jwildey/ec535Project/(commit log)

2017-04-09 Update bluetoothClient.c
    Added the address of the robotic arm for bluetooth
2017-04-30 added folder for raspberry pi code
2017-04-30 add code running on raspberry pi
2017-04-30 add arduino code for arm
2017-05-01 inverted logic on gripper state
    [gloveDriver.c]
